rstiebel/Bohlebots_Atlantis/README

This is the Bohlebots Atlantis folder.
It contains all the files that have been used to create the robocup 2vs2 vision soccer bots

Also have a look at the main Bohlebots Github:
https://github.com/bohlebots/soccer
