rstiebel/Bohlebots_Atlantis/Hardware/tasterPlatine2025_01.kicad_pcb

## KiCad design Hardware/tasterPlatine2025_01.kicad_pcb (2026-06-28)

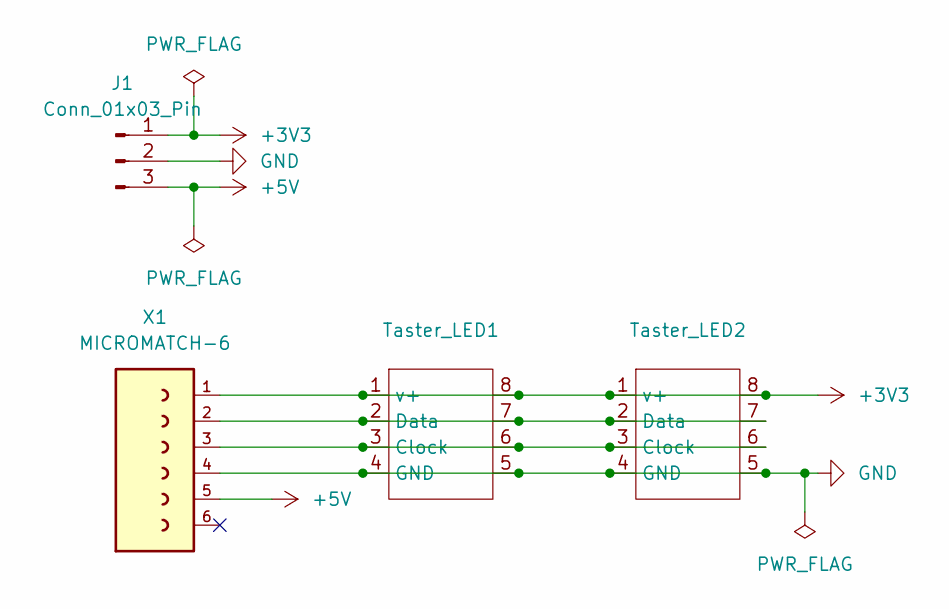
[picture p1: schematic tasterPlatine2025_01.kicad_sch]

Parts:
J1: Conn_01x03_Pin; PinHeader_1x03_P2.54mm_Vertical
Taster_LED1, Taster_LED2: TASTER_LED
X1: MICROMATCH-6

Connections:
+3V3: J1.1, Taster_LED1.1 (v+), Taster_LED1.8, Taster_LED2.1 (v+), Taster_LED2.8, X1.1
+5V: J1.3, X1.5
GND: J1.2, Taster_LED1.4 (GND), Taster_LED1.5, Taster_LED2.4 (GND), Taster_LED2.5, X1.4
unnamed: Taster_LED1.3 (Clock), Taster_LED1.6, Taster_LED2.3 (Clock), Taster_LED2.6, X1.3
unnamed: Taster_LED1.2 (Data), Taster_LED1.7, Taster_LED2.2 (Data), Taster_LED2.7, X1.2

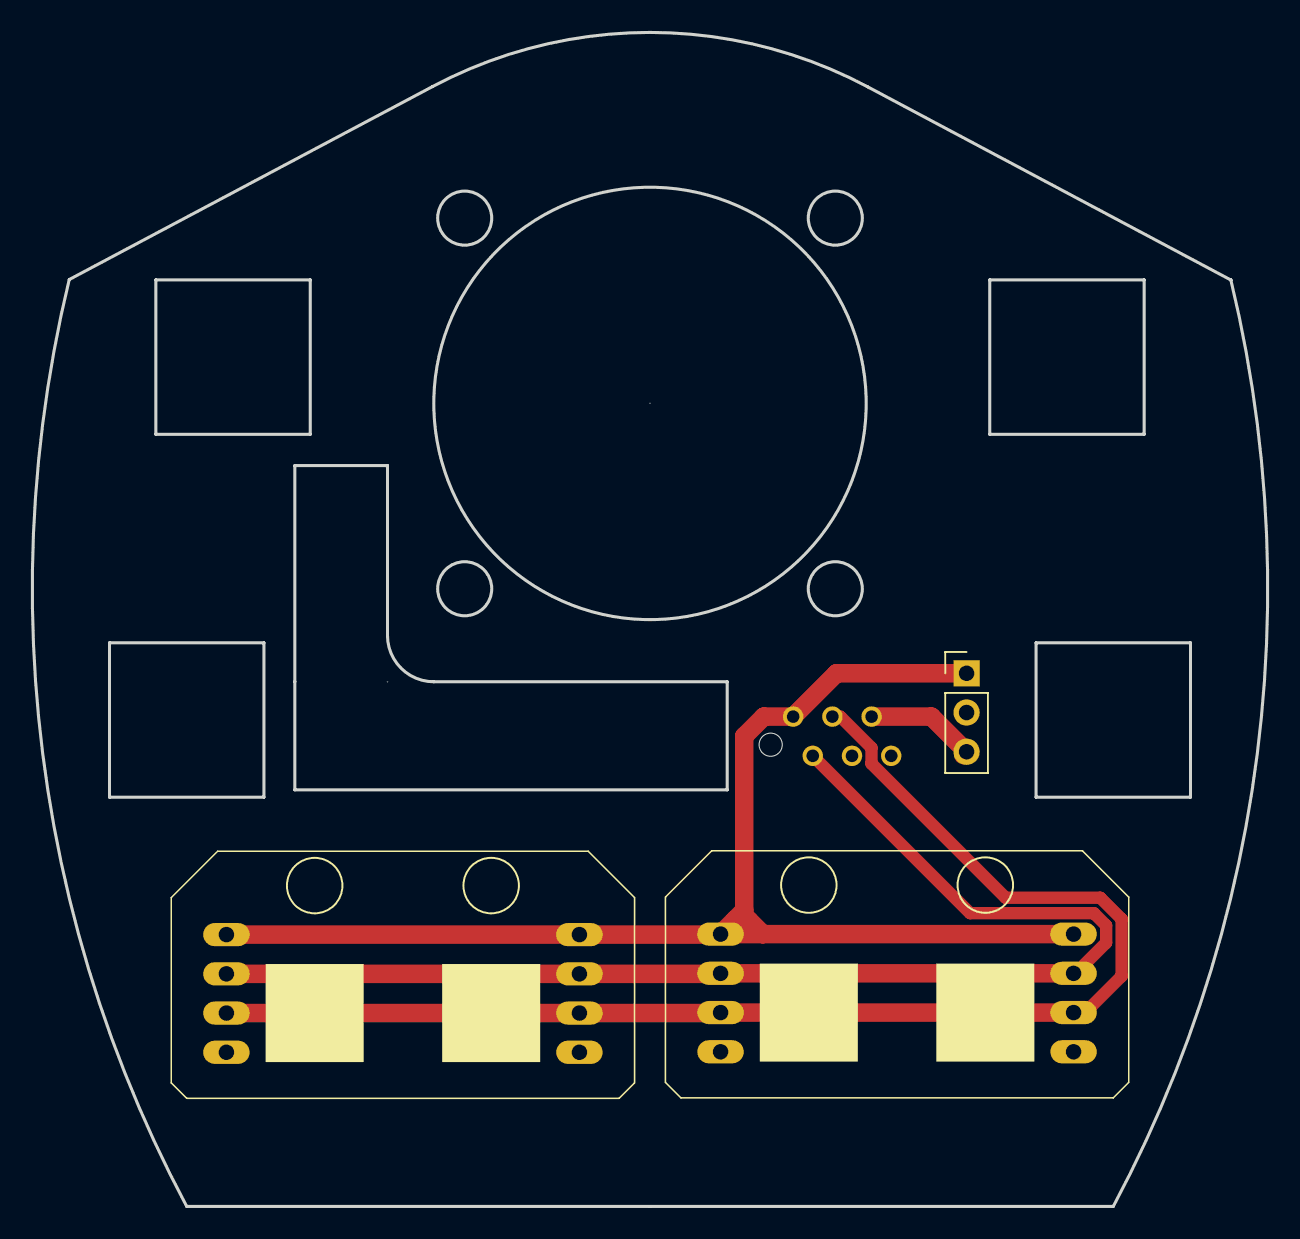
[picture p2: board tasterPlatine2025_01.kicad_pcb from above]

Board: 2 copper layers, 80.0 x 76.0 mm, 4 parts (1 on the bottom side), 5 nets.
