rstiebel/Bohlebots_Atlantis/Hardware/MainPlatine.kicad_pcb

## KiCad design Hardware/MainPlatine.kicad_pcb (2026-06-28)

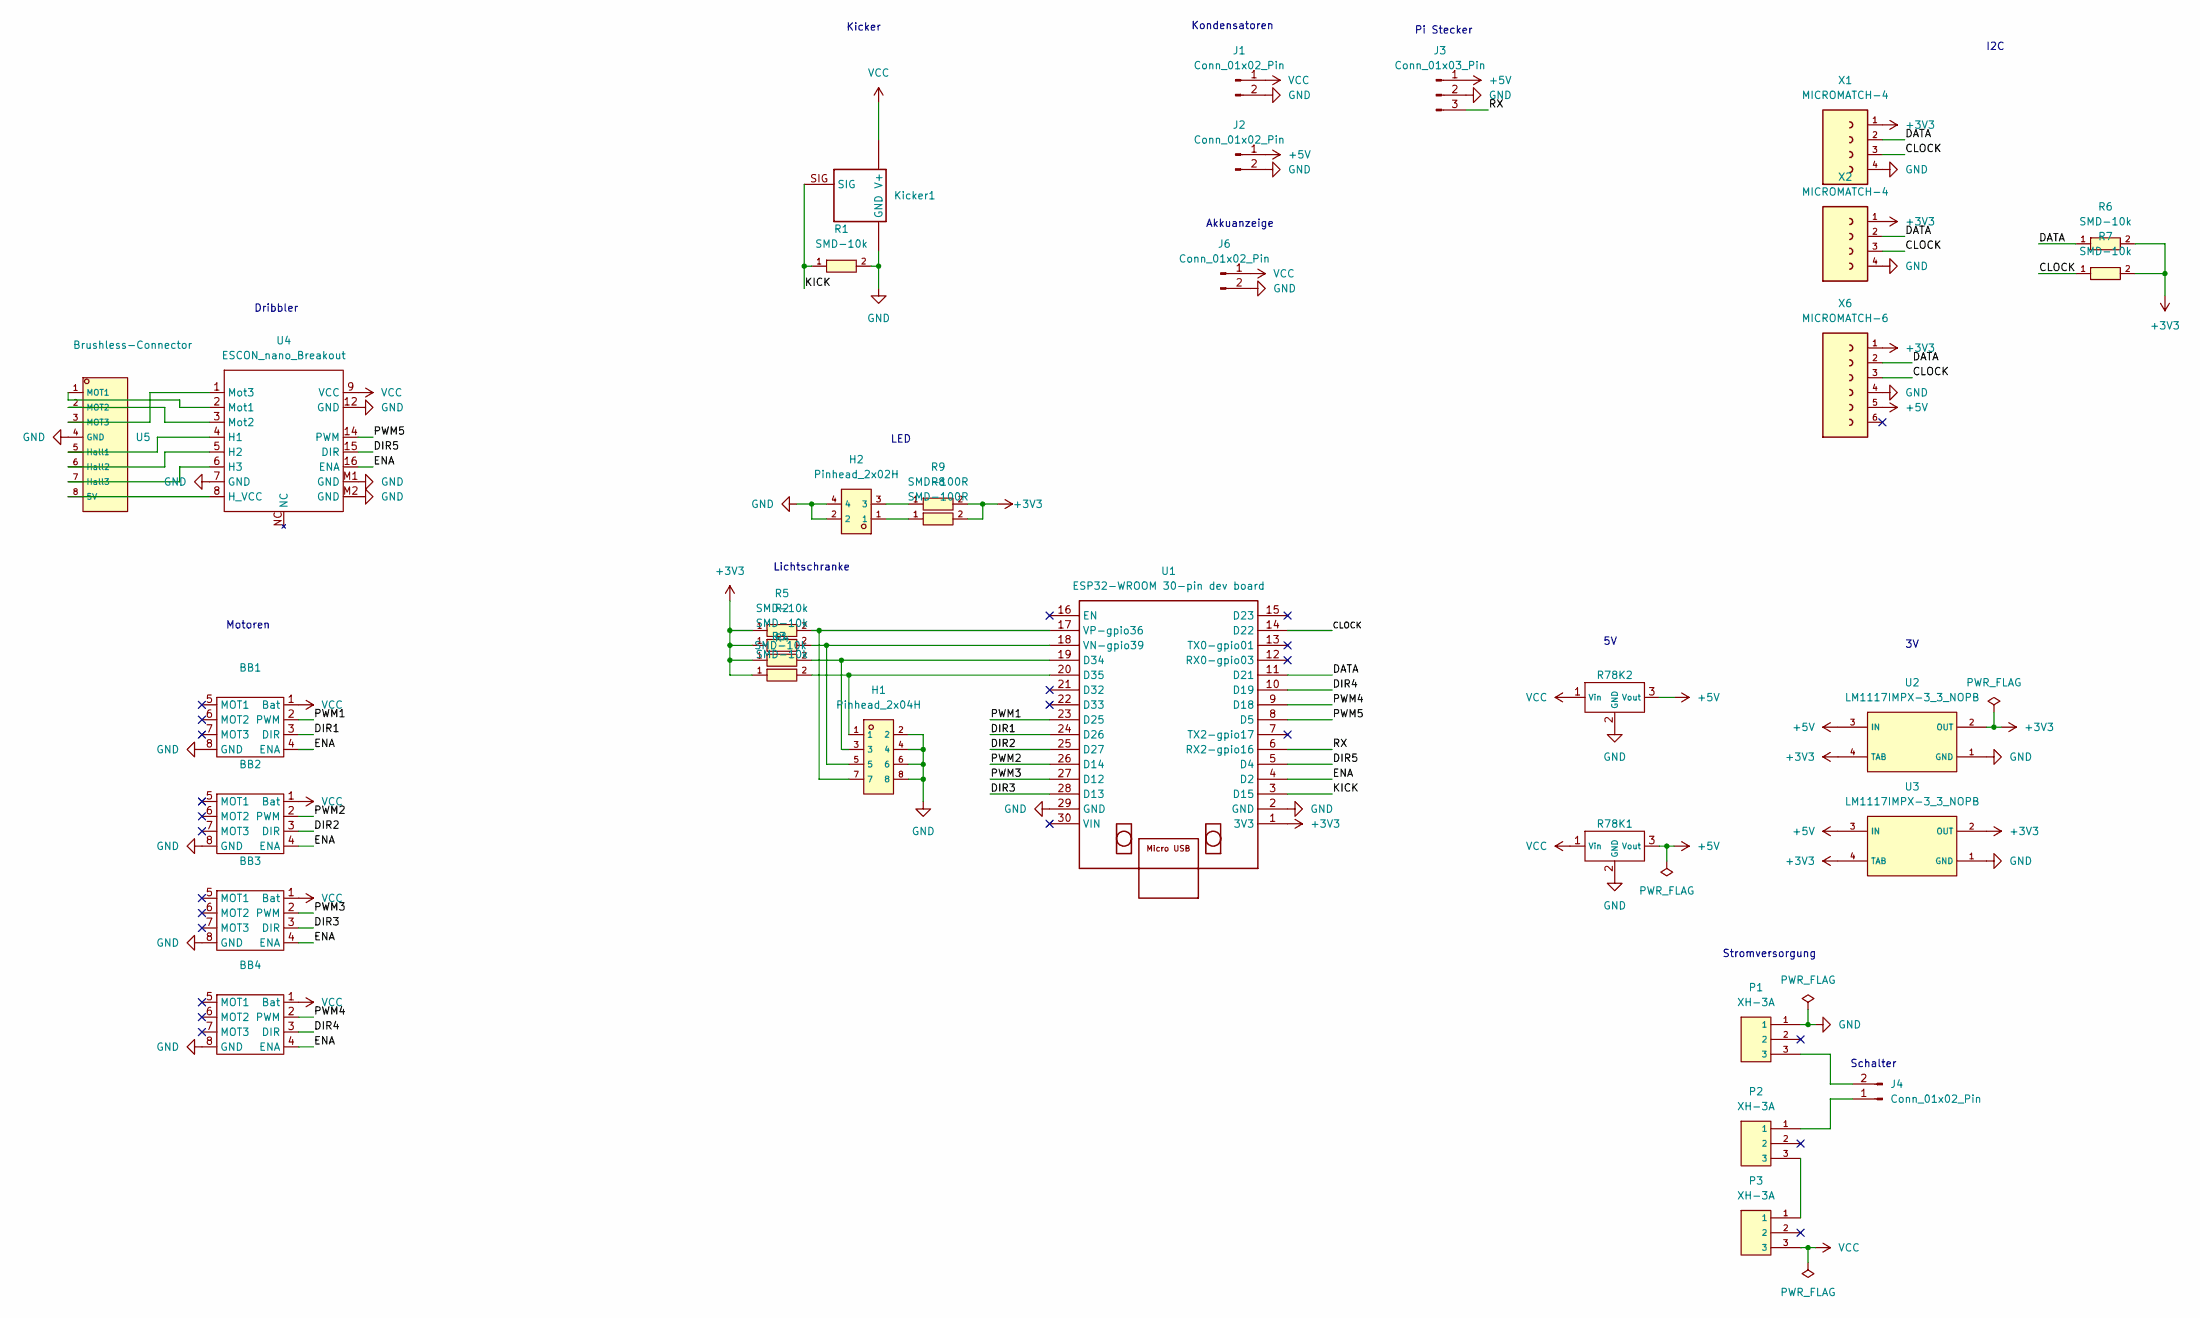
[picture p3: schematic MainPlatine.kicad_sch]

Parts:
BB1, BB2, BB3, BB4: ESCON_nano_breakout_stie
H1: Pinhead_2x04H; PinHeader_2x04_P2.54mm_Vertical; LCSC C706885
H2: Pinhead_2x02H; PinHeader_2x02_P2.54mm_Vertical; LCSC C706883
J1, J2, J4, J6: Conn_01x02_Pin; PinHeader_1x02_P2.54mm_Vertical
J3: Conn_01x03_Pin; PinHeader_1x03_P2.54mm_Vertical
Kicker1: KICKER
P1, P2, P3: XH-3A; CONN-TH_XH-3A; LCSC C2316
R1, R2, R3, R4, R5, R6, R7: SMD-10k; R0603; LCSC C25804
R8, R9: SMD-100R; R0603; LCSC C22775
R78K1, R78K2: R785K
U1: ESP32-WROOM 30-pin dev board; MODULE_ESP32_DEVKIT_V1
U2, U3: LM1117IMPX-3_3_NOPB; SOT-223_L6.5-W3.5-P2.30-LS7.0-BR; LCSC C23984
U4: ESCON_nano_Breakout; ESCON 24-2 Breakout
U5: Brushless-Connector; CONN-TH_B8B-PH-K-S-LF-SN; LCSC C157974
X1, X2: MICROMATCH-4
X6: MICROMATCH-6

Connections:
+3V3: R2.1, R3.1, R4.1, R5.1, R6.2, R7.2, R8.2, R9.2, U1.1 (3V3), U2.2 (OUT), U2.4 (TAB), U3.2 (OUT), U3.4 (TAB), X1.1, X2.1, X6.1
+5V: J2.1, J3.1, R78K1.3 (Vout), R78K2.3 (Vout), U2.3 (IN), U3.3 (IN), X6.5
/CLOCK: R7.1, U1.14 (D22), X1.3, X2.3, X6.3
/DATA: R6.1, U1.11 (D21), X1.2, X2.2, X6.2
/DIR1: BB1.3 (DIR), U1.24 (D26)
/DIR2: BB2.3 (DIR), U1.25 (D27)
/DIR3: BB3.3 (DIR), U1.28 (D13)
/DIR4: BB4.3 (DIR), U1.10 (D19)
/DIR5: U1.5 (D4), U4.15 (DIR)
/ENA: BB1.4 (ENA), BB2.4 (ENA), BB3.4 (ENA), BB4.4 (ENA), U1.4 (D2), U4.16 (ENA)
/KICK: Kicker1.SIG, R1.1, U1.3 (D15)
/PWM1: BB1.2 (PWM), U1.23 (D25)
/PWM2: BB2.2 (PWM), U1.26 (D14)
/PWM3: BB3.2 (PWM), U1.27 (D12)
/PWM4: BB4.2 (PWM), U1.9 (D18)
/PWM5: U1.8 (D5), U4.14 (PWM)
/RX: J3.3, U1.6 (RX2-gpio16)
GND: BB1.8 (GND), BB2.8 (GND), BB3.8 (GND), BB4.8 (GND), H1.2, H1.4, H1.6, H1.8, H2.2, H2.4, J1.2, J2.2, J3.2, J6.2, Kicker1.GND1 (GND), Kicker1.GND2 (GND), Kicker1.GND3 (GND), Kicker1.GND4 (GND), Kicker1.GND5 (GND), Kicker1.GND6 (GND), Kicker1.GND7 (GND), Kicker1.GND8 (GND), P1.1, R1.2, R78K1.2 (GND), R78K2.2 (GND), U1.2 (GND), U1.29 (GND), U2.1 (GND), U3.1 (GND), U4.7 (GND), U4.12 (GND), U4.13 (GND), U4.M1 (GND), U4.M2 (GND), U5.4 (GND), X1.4, X2.4, X6.4
unnamed: H2.1, R8.1
unnamed: H2.3, R9.1
unnamed: J4.1, P2.1
unnamed: J4.2, P1.3
unnamed: P2.3, P3.1
unnamed: H1.3, R3.2, U1.19 (D34)
unnamed: H1.1, R4.2, U1.20 (D35)
unnamed: H1.5, R2.2, U1.18 (VN-gpio39)
unnamed: H1.7, R5.2, U1.17 (VP-gpio36)
unnamed: U4.4 (H1), U5.5 (Hall1)
unnamed: U4.5 (H2), U5.6 (Hall2)
unnamed: U4.6 (H3), U5.7 (Hall3)
unnamed: U4.8 (H_VCC), U5.8 (5V)
unnamed: U4.2 (Mot1), U5.1 (MOT1)
unnamed: U4.3 (Mot2), U5.2 (MOT2)
unnamed: U4.1 (Mot3), U5.3 (MOT3)
VCC: BB1.1 (Bat), BB2.1 (Bat), BB3.1 (Bat), BB4.1 (Bat), J1.1, J6.1, Kicker1.V+1 (V+), Kicker1.V+2 (V+), Kicker1.V+3 (V+), P3.3, R78K1.1 (Vin), R78K2.1 (Vin), U4.9 (VCC), U4.10 (VCC), U4.11 (VCC)

Notes on the sheet:
I2C
Kondensatoren
Stromversorgung
Pi Stecker
Schalter
Dribbler
Kicker
LED
Akkuanzeige
Motoren
Lichtschranke

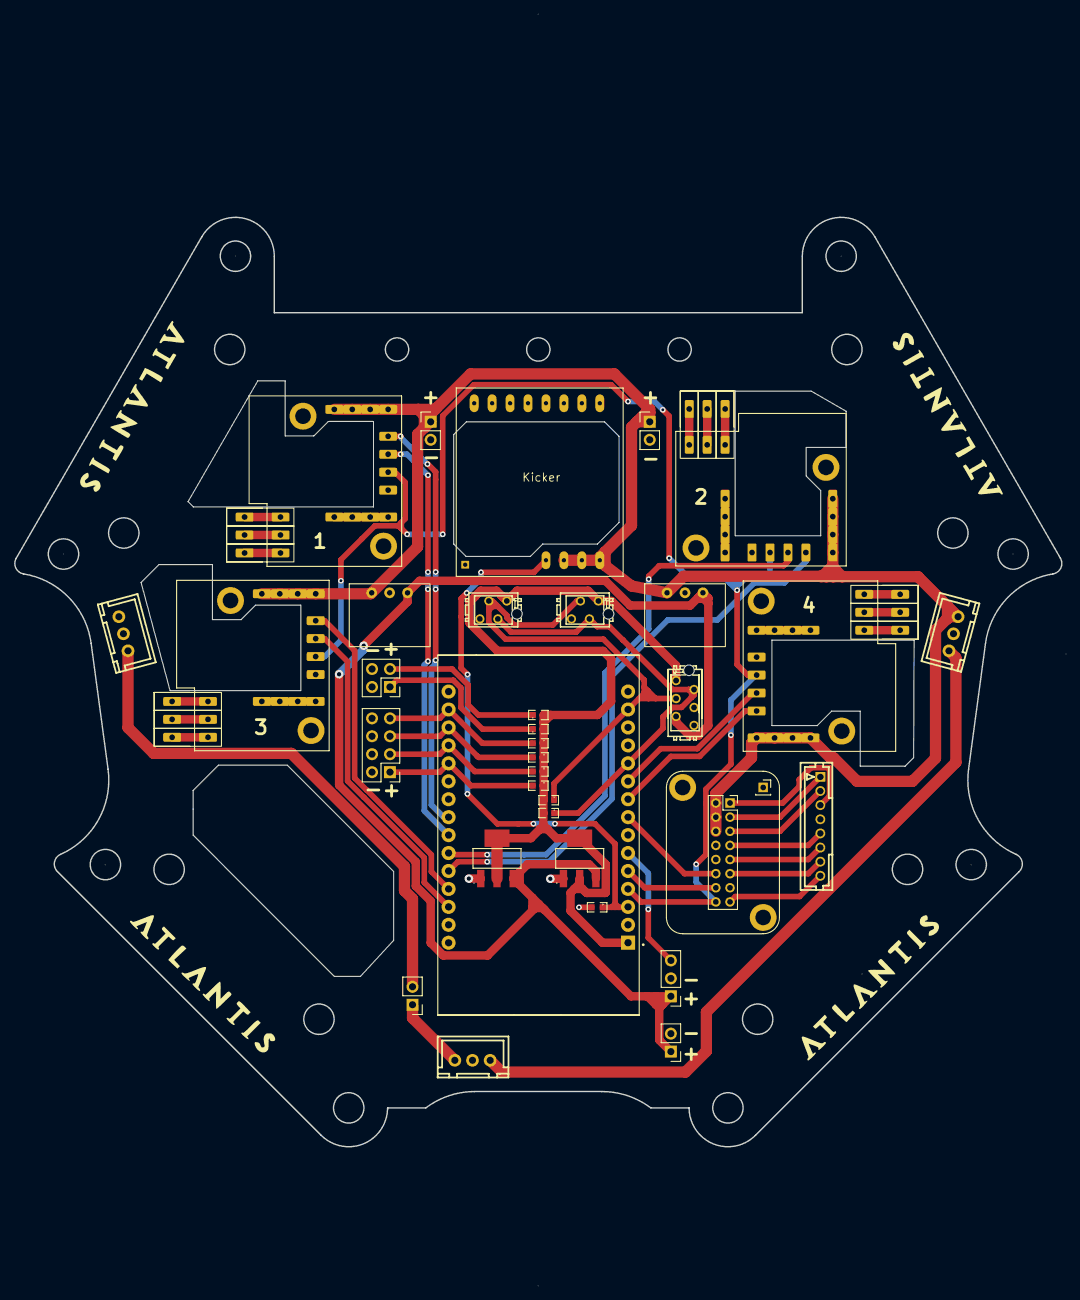
[picture p4: board MainPlatine.kicad_pcb from above]

Board: 2 copper layers, 148.2 x 131.6 mm, 34 parts (0 on the bottom side), 35 nets.
