rstiebel/Bohlebots_Atlantis/Hardware/Bodensensor_2025_final.kicad_pcb

## KiCad design Hardware/Bodensensor_2025_final.kicad_pcb (2026-06-28)

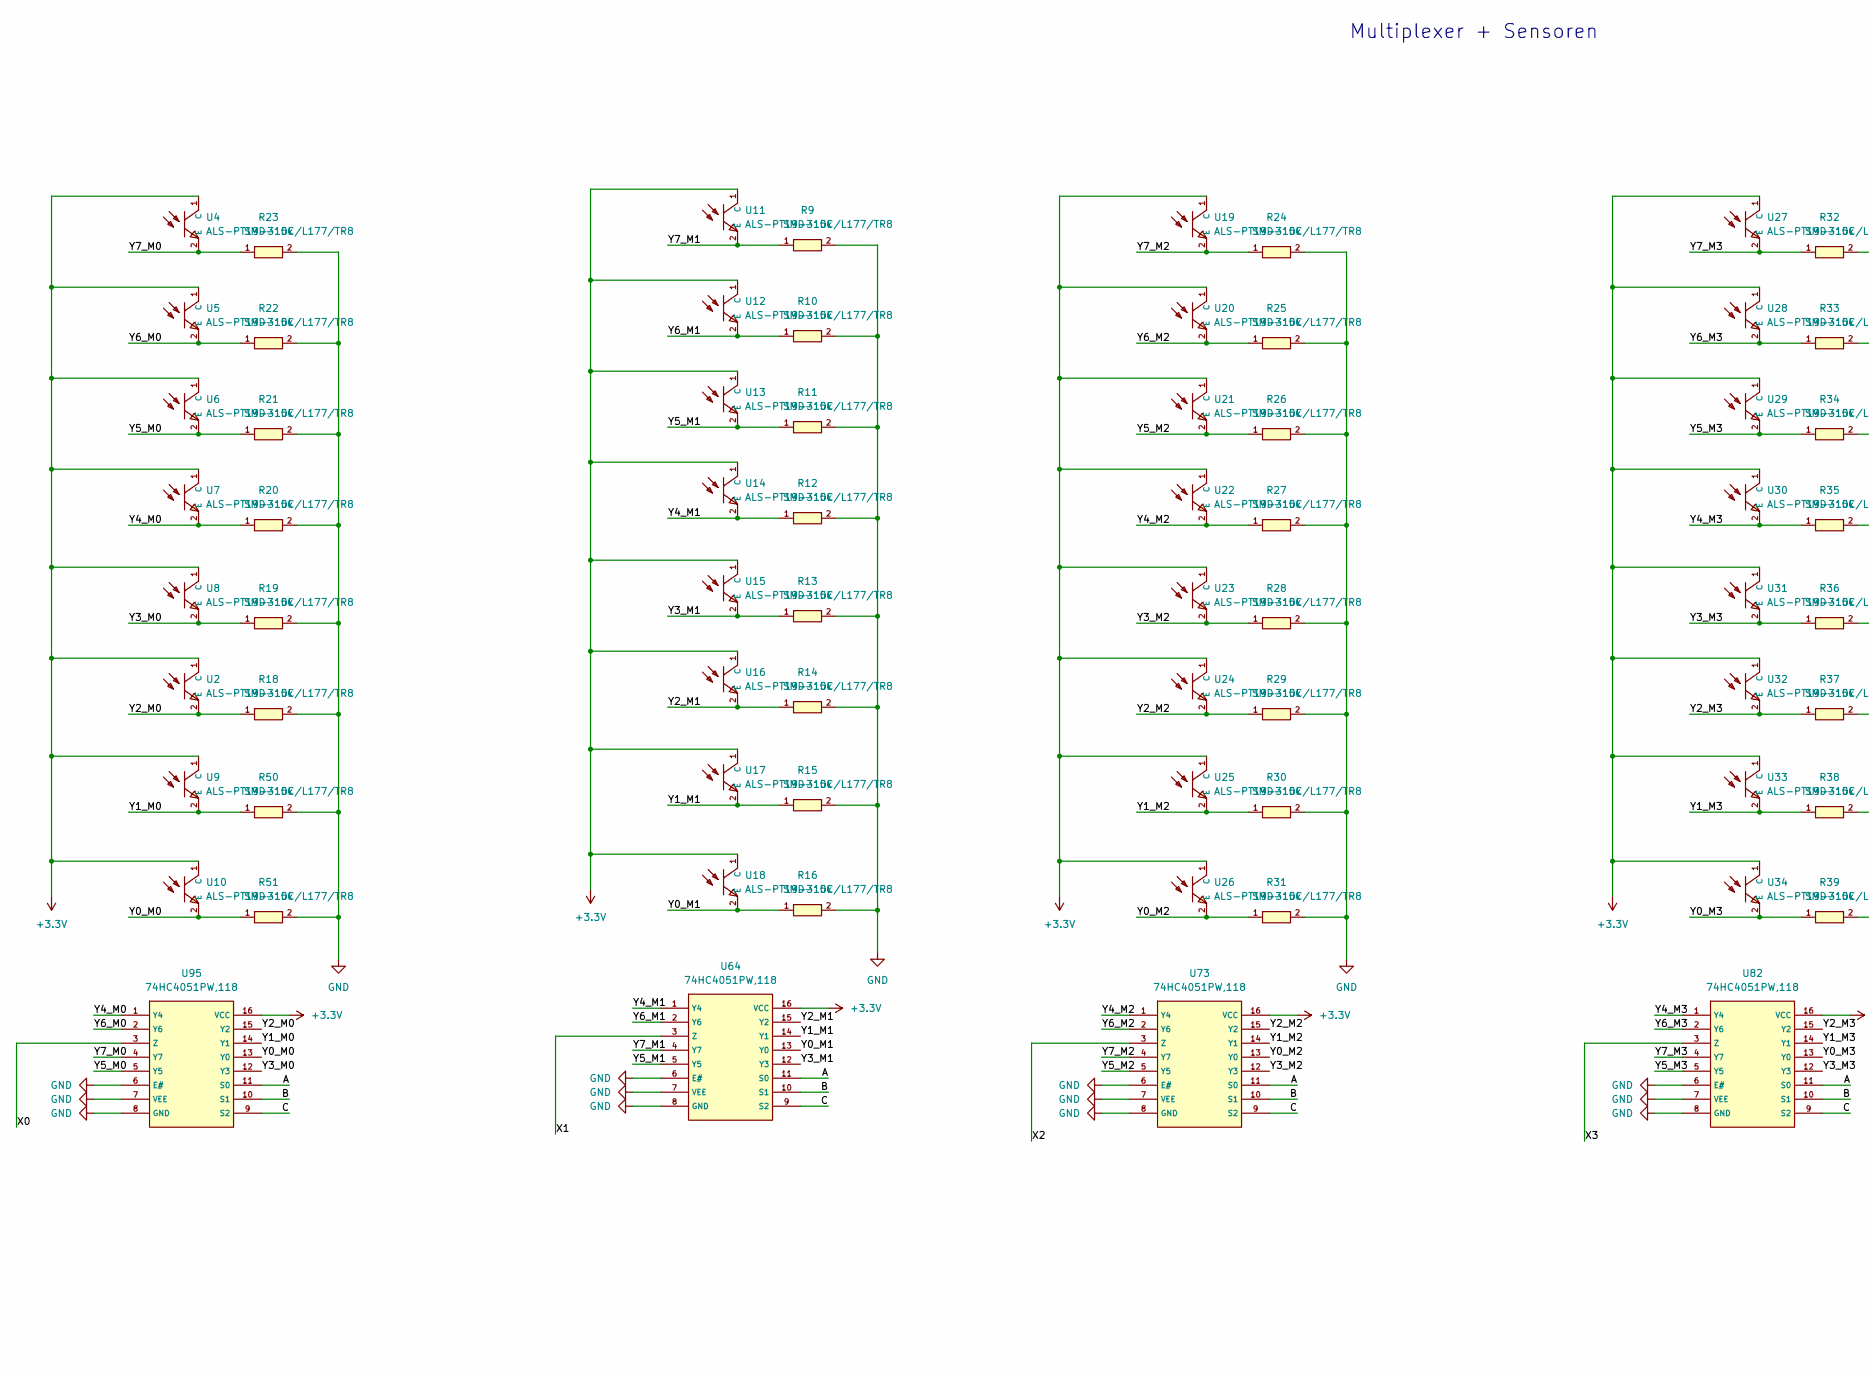
[picture p5: schematic Bodensensor_2025_final.kicad_sch, part in row 1, column 1]

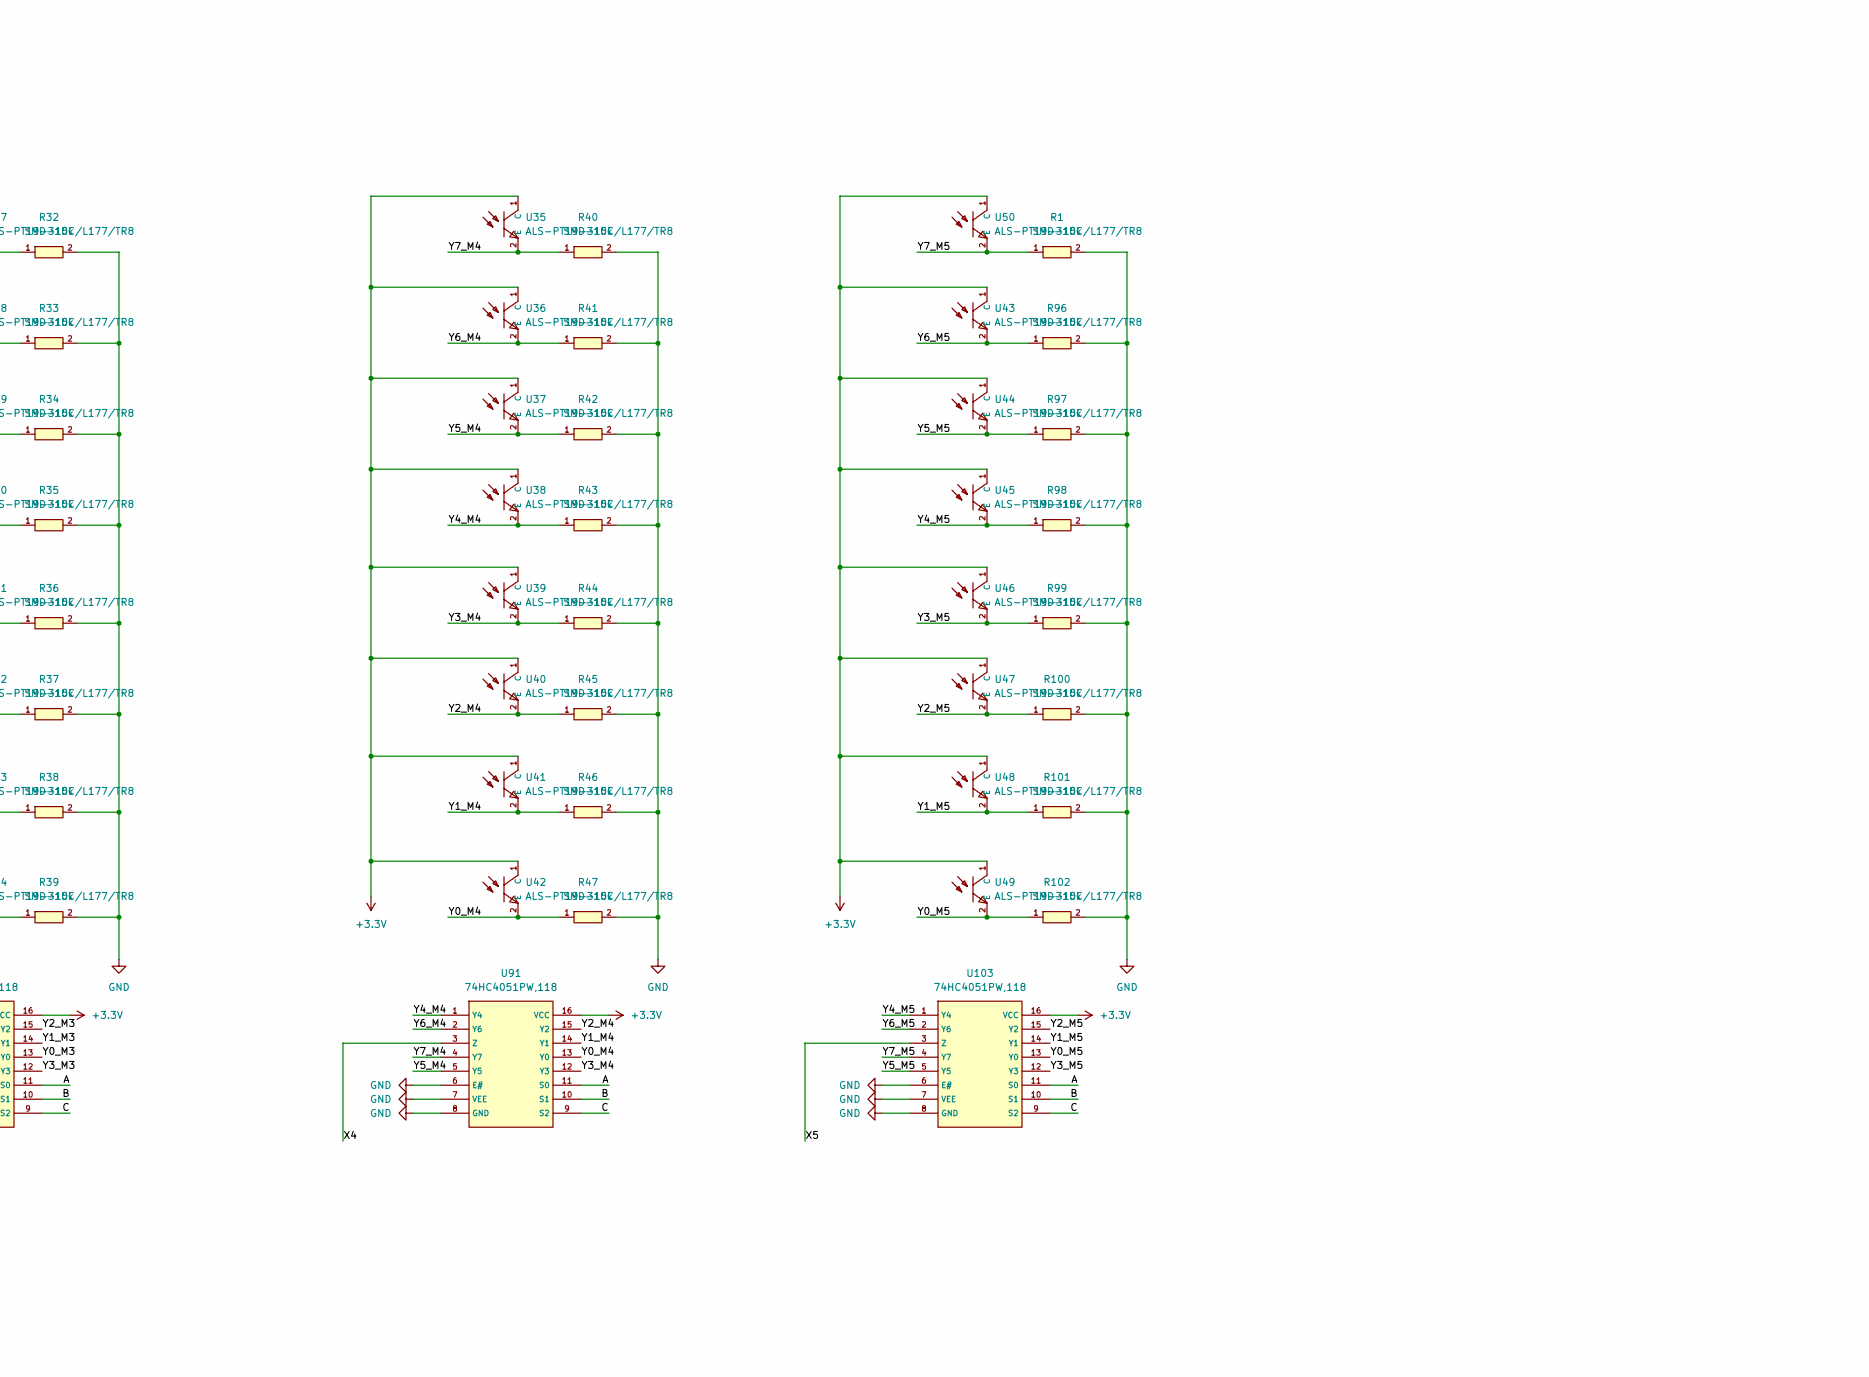
[picture p6: schematic Bodensensor_2025_final.kicad_sch, part in row 1, column 2]

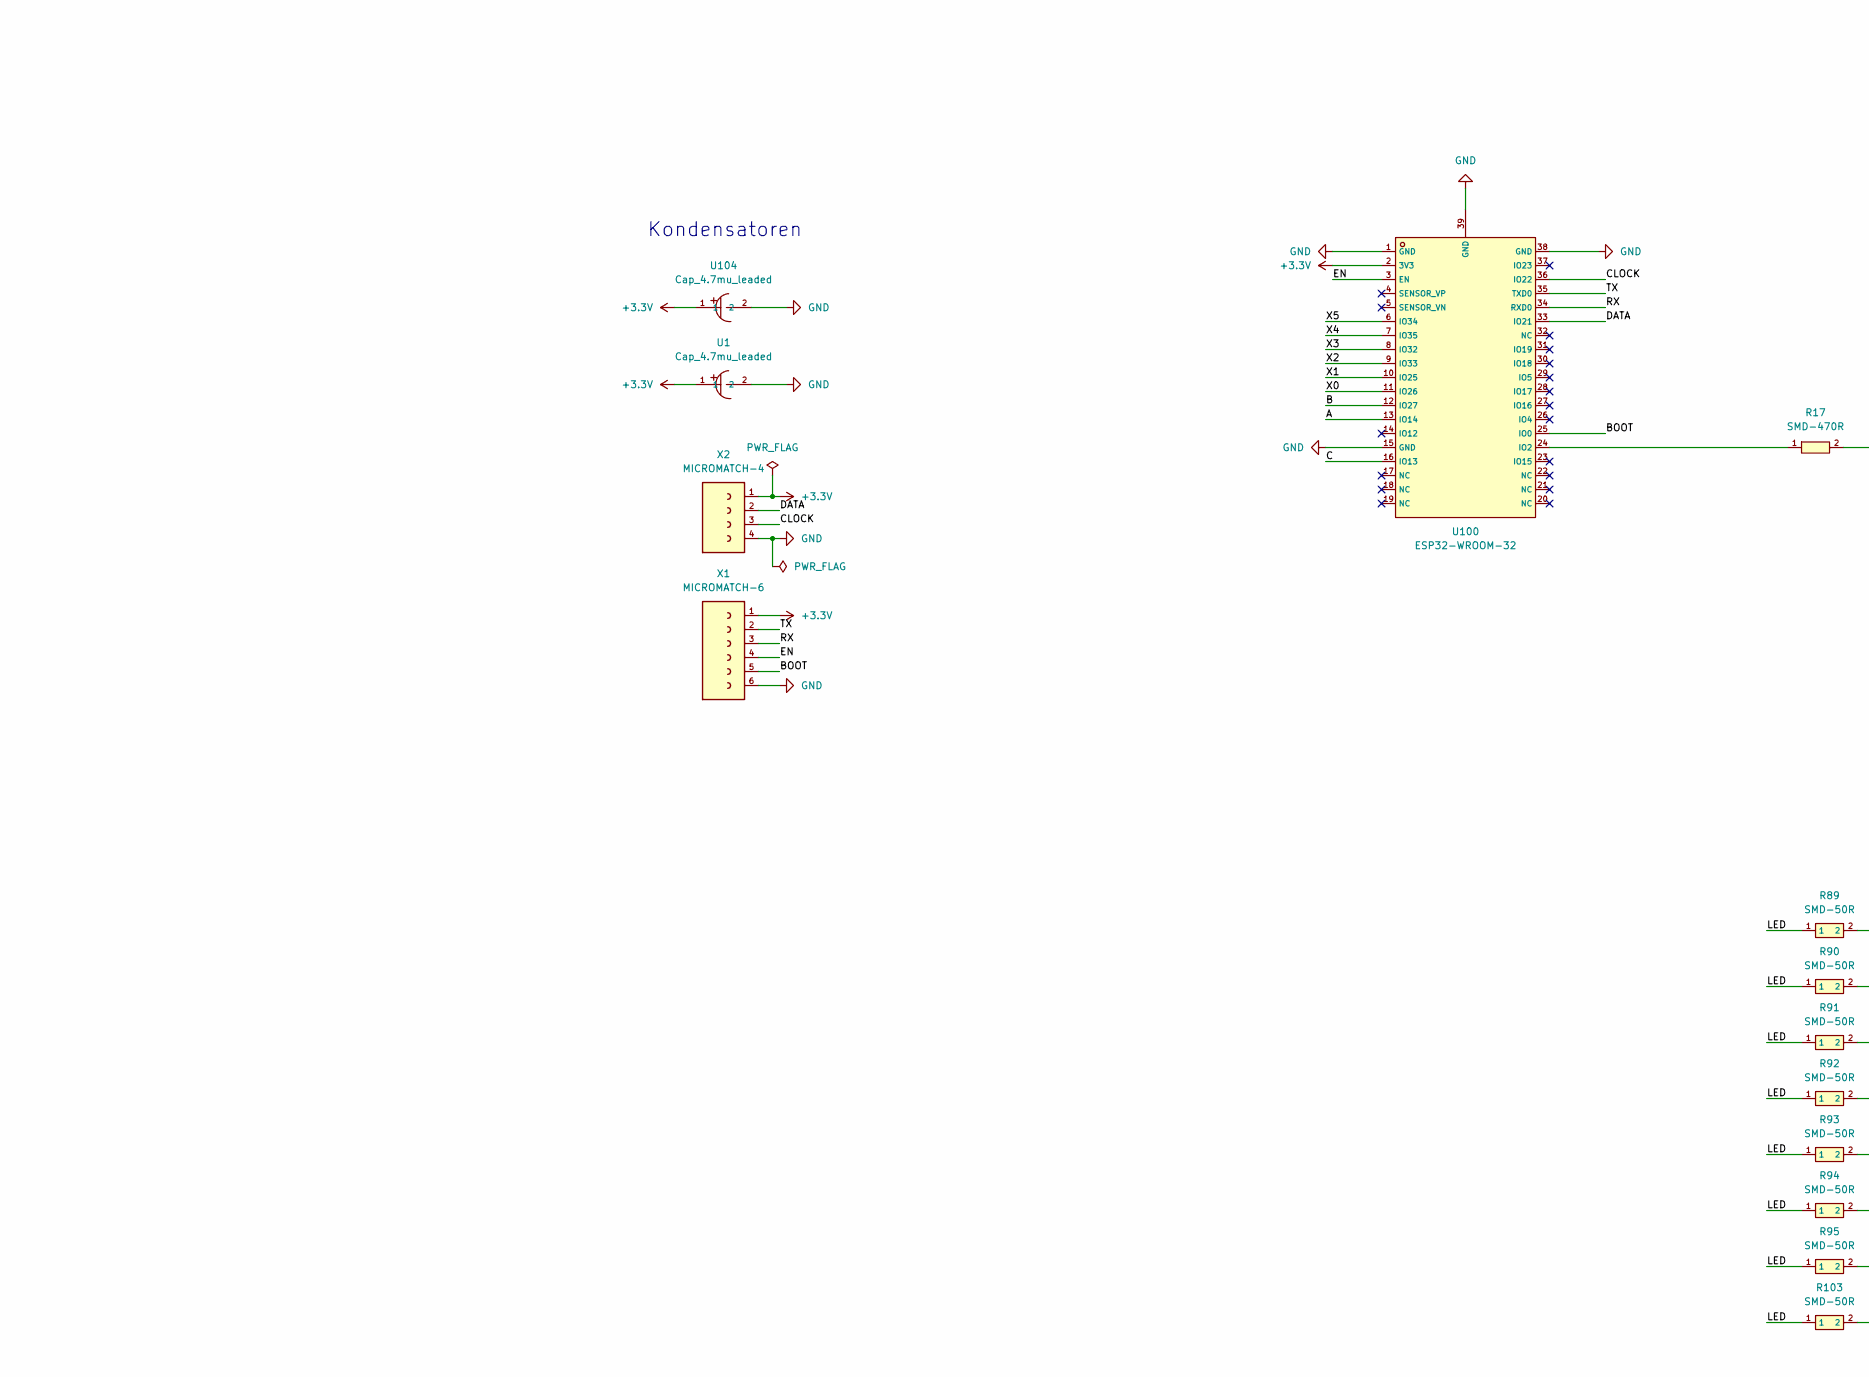
[picture p7: schematic Bodensensor_2025_final.kicad_sch, part in row 2, column 1]

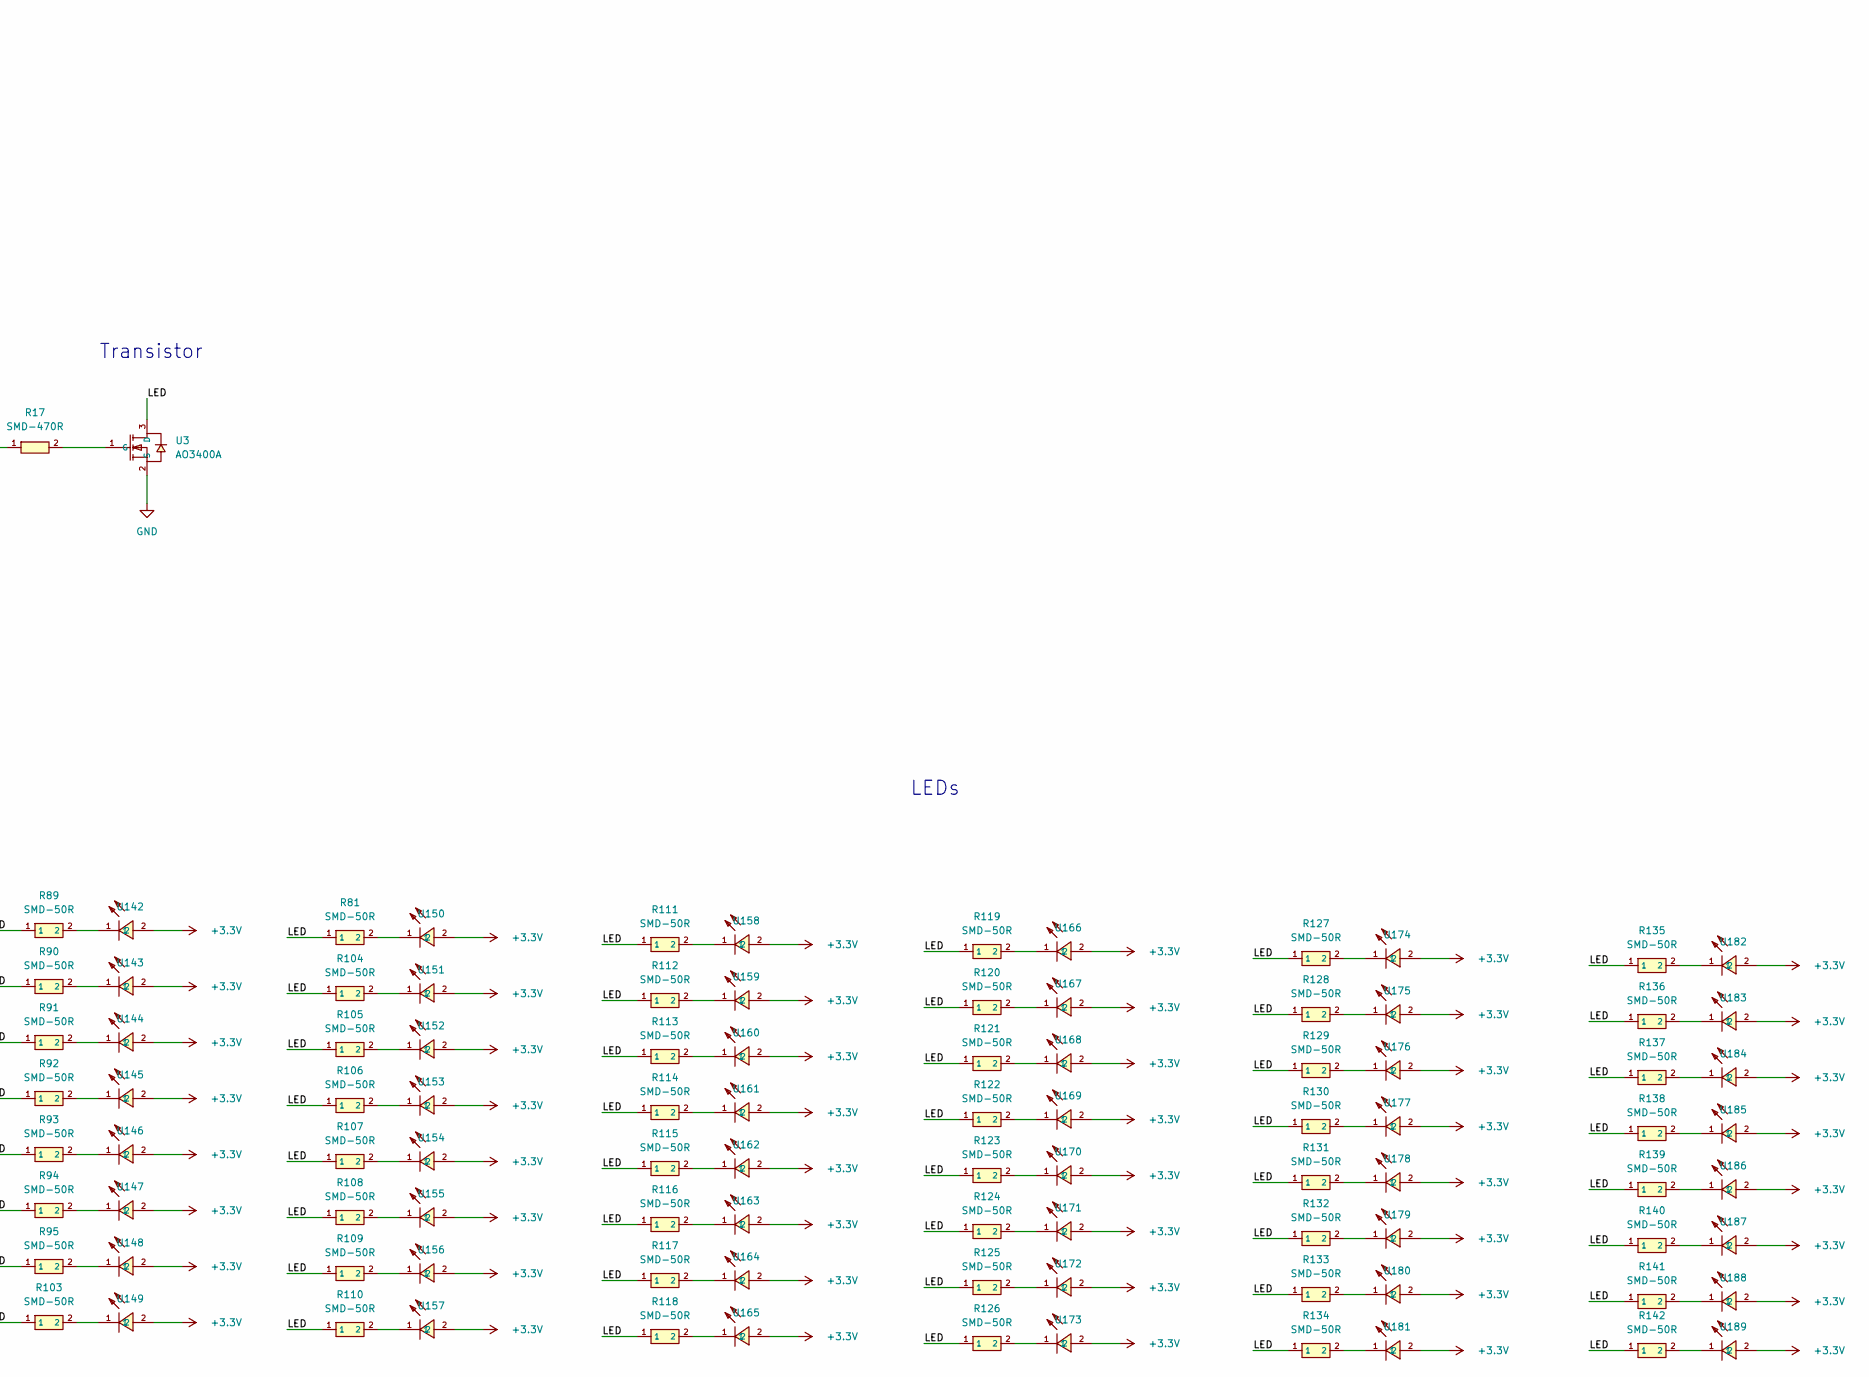
[picture p8: schematic Bodensensor_2025_final.kicad_sch, part in row 2, column 2]

Parts:
R1, R9, R10, R11, R12, R13, R14, R15, R16, R18, R19, R20, R21, R22, R23, R24, R25, R26, R27, R28, R29, R30, R31, R32, R33, R34, R35, R36, R37, R38, R39, R40, R41, R42, R43, R44, R45, R46, R47, R50, R51, R96, R97, R98, R99, R100, R101, R102: SMD-10k; R0603; LCSC C25804
R17: SMD-470R; R0603; LCSC C23162
R81, R89, R90, R91, R92, R93, R94, R95, R103, R104, R105, R106, R107, R108, R109, R110, R111, R112, R113, R114, R115, R116, R117, R118, R119, R120, R121, R122, R123, R124, R125, R126, R127, R128, R129, R130, R131, R132, R133, R134, R135, R136, R137, R138, R139, R140, R141, R142: SMD-50R; R0603; LCSC C849792
U1, U104: Cap_4.7mu_leaded; CAP-TH_BD4.0-P1.50-D0.5-FD; LCSC C2873979
U2, U4, U5, U6, U7, U8, U9, U10, U11, U12, U13, U14, U15, U16, U17, U18, U19, U20, U21, U22, U23, U24, U25, U26, U27, U28, U29, U30, U31, U32, U33, U34, U35, U36, U37, U38, U39, U40, U41, U42, U43, U44, U45, U46, U47, U48, U49, U50: ALS-PT19-315C/L177/TR8; SENSORS-SMD_ALS-PT19; LCSC C146233
U3: AO3400A; SOT-23-3_L2.9-W1.3-P1.90-LS2.4-BR; LCSC C20917
U64, U73, U82, U91, U95, U103: 74HC4051PW,118; TSSOP-16_L5.0-W4.4-P0.65-LS6.4-BL; LCSC C5645
U100: ESP32-WROOM-32; WIFI-SMD_ESP32-WROOM-32UE; LCSC C701344
U142, U143, U144, U145, U146, U147, U148, U149, U150, U151, U152, U153, U154, U155, U156, U157, U158, U159, U160, U161, U162, U163, U164, U165, U166, U167, U168, U169, U170, U171, U172, U173, U174, U175, U176, U177, U178, U179, U180, U181, U182, U183, U184, U185, U186, U187, U188, U189: LED weiß 4000k Bodensensor HL-AM-2835H489W-S1-08H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; LED-SMD_L3.3-W2.8-RD; LCSC C210311
X1: MICROMATCH-6
X2: MICROMATCH-4

Connections:
+3.3V: U1.1, U2.1 (C), U4.1 (C), U5.1 (C), U6.1 (C), U7.1 (C), U8.1 (C), U9.1 (C), U10.1 (C), U11.1 (C), U12.1 (C), U13.1 (C), U14.1 (C), U15.1 (C), U16.1 (C), U17.1 (C), U18.1 (C), U19.1 (C), U20.1 (C), U21.1 (C), U22.1 (C), U23.1 (C), U24.1 (C), U25.1 (C), U26.1 (C), U27.1 (C), U28.1 (C), U29.1 (C), U30.1 (C), U31.1 (C), U32.1 (C), U33.1 (C), U34.1 (C), U35.1 (C), U36.1 (C), U37.1 (C), U38.1 (C), U39.1 (C), U40.1 (C), U41.1 (C), U42.1 (C), U43.1 (C), U44.1 (C), U45.1 (C), U46.1 (C), U47.1 (C), U48.1 (C), U49.1 (C), U50.1 (C), U64.16 (VCC), U73.16 (VCC), U82.16 (VCC), U91.16 (VCC), U95.16 (VCC), U100.2 (3V3), U103.16 (VCC), U104.1, U142.2, U143.2, U144.2, U145.2, U146.2, U147.2, U148.2, U149.2, U150.2, U151.2, U152.2, U153.2, U154.2, U155.2, U156.2, U157.2, U158.2, U159.2, U160.2, U161.2, U162.2, U163.2, U164.2, U165.2, U166.2, U167.2, U168.2, U169.2, U170.2, U171.2, U172.2, U173.2, U174.2, U175.2, U176.2, U177.2, U178.2, U179.2, U180.2, U181.2, U182.2, U183.2, U184.2, U185.2, U186.2, U187.2, U188.2, U189.2, X1.1, X2.1
/A: U64.11 (S0), U73.11 (S0), U82.11 (S0), U91.11 (S0), U95.11 (S0), U100.13 (IO14), U103.11 (S0)
/B: U64.10 (S1), U73.10 (S1), U82.10 (S1), U91.10 (S1), U95.10 (S1), U100.12 (IO27), U103.10 (S1)
/BOOT: U100.25 (IO0), X1.5
/C: U64.9 (S2), U73.9 (S2), U82.9 (S2), U91.9 (S2), U95.9 (S2), U100.16 (IO13), U103.9 (S2)
/CLOCK: U100.36 (IO22), X2.3
/DATA: U100.33 (IO21), X2.2
/EN: U100.3 (EN), X1.4
/LED: R81.1, R89.1, R90.1, R91.1, R92.1, R93.1, R94.1, R95.1, R103.1, R104.1, R105.1, R106.1, R107.1, R108.1, R109.1, R110.1, R111.1, R112.1, R113.1, R114.1, R115.1, R116.1, R117.1, R118.1, R119.1, R120.1, R121.1, R122.1, R123.1, R124.1, R125.1, R126.1, R127.1, R128.1, R129.1, R130.1, R131.1, R132.1, R133.1, R134.1, R135.1, R136.1, R137.1, R138.1, R139.1, R140.1, R141.1, R142.1, U3.3 (D)
/RX: U100.34 (RXD0), X1.3
/TX: U100.35 (TXD0), X1.2
/X0: U95.3 (Z), U100.11 (IO26)
/X1: U64.3 (Z), U100.10 (IO25)
/X2: U73.3 (Z), U100.9 (IO33)
/X3: U82.3 (Z), U100.8 (IO32)
/X4: U91.3 (Z), U100.7 (IO35)
/X5: U100.6 (IO34), U103.3 (Z)
/Y0_M0: R51.1, U10.2 (E), U95.13 (Y0)
/Y0_M1: R16.1, U18.2 (E), U64.13 (Y0)
/Y0_M2: R31.1, U26.2 (E), U73.13 (Y0)
/Y0_M3: R39.1, U34.2 (E), U82.13 (Y0)
/Y0_M4: R47.1, U42.2 (E), U91.13 (Y0)
/Y0_M5: R102.1, U49.2 (E), U103.13 (Y0)
/Y1_M0: R50.1, U9.2 (E), U95.14 (Y1)
/Y1_M1: R15.1, U17.2 (E), U64.14 (Y1)
/Y1_M2: R30.1, U25.2 (E), U73.14 (Y1)
/Y1_M3: R38.1, U33.2 (E), U82.14 (Y1)
/Y1_M4: R46.1, U41.2 (E), U91.14 (Y1)
/Y1_M5: R101.1, U48.2 (E), U103.14 (Y1)
/Y2_M0: R18.1, U2.2 (E), U95.15 (Y2)
/Y2_M1: R14.1, U16.2 (E), U64.15 (Y2)
/Y2_M2: R29.1, U24.2 (E), U73.15 (Y2)
/Y2_M3: R37.1, U32.2 (E), U82.15 (Y2)
/Y2_M4: R45.1, U40.2 (E), U91.15 (Y2)
/Y2_M5: R100.1, U47.2 (E), U103.15 (Y2)
/Y3_M0: R19.1, U8.2 (E), U95.12 (Y3)
/Y3_M1: R13.1, U15.2 (E), U64.12 (Y3)
/Y3_M2: R28.1, U23.2 (E), U73.12 (Y3)
/Y3_M3: R36.1, U31.2 (E), U82.12 (Y3)
/Y3_M4: R44.1, U39.2 (E), U91.12 (Y3)
/Y3_M5: R99.1, U46.2 (E), U103.12 (Y3)
/Y4_M0: R20.1, U7.2 (E), U95.1 (Y4)
/Y4_M1: R12.1, U14.2 (E), U64.1 (Y4)
/Y4_M2: R27.1, U22.2 (E), U73.1 (Y4)
/Y4_M3: R35.1, U30.2 (E), U82.1 (Y4)
/Y4_M4: R43.1, U38.2 (E), U91.1 (Y4)
/Y4_M5: R98.1, U45.2 (E), U103.1 (Y4)
/Y5_M0: R21.1, U6.2 (E), U95.5 (Y5)
/Y5_M1: R11.1, U13.2 (E), U64.5 (Y5)
/Y5_M2: R26.1, U21.2 (E), U73.5 (Y5)
/Y5_M3: R34.1, U29.2 (E), U82.5 (Y5)
/Y5_M4: R42.1, U37.2 (E), U91.5 (Y5)
/Y5_M5: R97.1, U44.2 (E), U103.5 (Y5)
/Y6_M0: R22.1, U5.2 (E), U95.2 (Y6)
/Y6_M1: R10.1, U12.2 (E), U64.2 (Y6)
/Y6_M2: R25.1, U20.2 (E), U73.2 (Y6)
/Y6_M3: R33.1, U28.2 (E), U82.2 (Y6)
/Y6_M4: R41.1, U36.2 (E), U91.2 (Y6)
/Y6_M5: R96.1, U43.2 (E), U103.2 (Y6)
/Y7_M0: R23.1, U4.2 (E), U95.4 (Y7)
/Y7_M1: R9.1, U11.2 (E), U64.4 (Y7)
/Y7_M2: R24.1, U19.2 (E), U73.4 (Y7)
/Y7_M3: R32.1, U27.2 (E), U82.4 (Y7)
/Y7_M4: R40.1, U35.2 (E), U91.4 (Y7)
/Y7_M5: R1.1, U50.2 (E), U103.4 (Y7)
GND: R1.2, R9.2, R10.2, R11.2, R12.2, R13.2, R14.2, R15.2, R16.2, R18.2, R19.2, R20.2, R21.2, R22.2, R23.2, R24.2, R25.2, R26.2, R27.2, R28.2, R29.2, R30.2, R31.2, R32.2, R33.2, R34.2, R35.2, R36.2, R37.2, R38.2, R39.2, R40.2, R41.2, R42.2, R43.2, R44.2, R45.2, R46.2, R47.2, R50.2, R51.2, R96.2, R97.2, R98.2, R99.2, R100.2, R101.2, R102.2, U1.2, U3.2 (S), U64.6 (E#), U64.7 (VEE), U64.8 (GND), U73.6 (E#), U73.7 (VEE), U73.8 (GND), U82.6 (E#), U82.7 (VEE), U82.8 (GND), U91.6 (E#), U91.7 (VEE), U91.8 (GND), U95.6 (E#), U95.7 (VEE), U95.8 (GND), U100.1 (GND), U100.15 (GND), U100.38 (GND), U100.39 (GND), U103.6 (E#), U103.7 (VEE), U103.8 (GND), U104.2, X1.6, X2.4
unnamed: R81.2, U150.1
unnamed: R89.2, U142.1
unnamed: R90.2, U143.1
unnamed: R91.2, U144.1
unnamed: R92.2, U145.1
unnamed: R93.2, U146.1
unnamed: R94.2, U147.1
unnamed: R95.2, U148.1
unnamed: R103.2, U149.1
unnamed: R104.2, U151.1
unnamed: R105.2, U152.1
unnamed: R106.2, U153.1
unnamed: R107.2, U154.1
unnamed: R108.2, U155.1
unnamed: R109.2, U156.1
unnamed: R110.2, U157.1
unnamed: R111.2, U158.1
unnamed: R112.2, U159.1
unnamed: R113.2, U160.1
unnamed: R114.2, U161.1
unnamed: R115.2, U162.1
unnamed: R116.2, U163.1
unnamed: R117.2, U164.1
unnamed: R118.2, U165.1
unnamed: R119.2, U166.1
unnamed: R120.2, U167.1
unnamed: R121.2, U168.1
unnamed: R122.2, U169.1
unnamed: R123.2, U170.1
unnamed: R124.2, U171.1
unnamed: R125.2, U172.1
unnamed: R126.2, U173.1
unnamed: R127.2, U174.1
unnamed: R128.2, U175.1
unnamed: R129.2, U176.1
unnamed: R130.2, U177.1
unnamed: R131.2, U178.1
unnamed: R132.2, U179.1
unnamed: R133.2, U180.1
unnamed: R134.2, U181.1
unnamed: R135.2, U182.1
unnamed: R136.2, U183.1
unnamed: R137.2, U184.1
unnamed: R138.2, U185.1
unnamed: R139.2, U186.1
unnamed: R140.2, U187.1
unnamed: R141.2, U188.1
unnamed: R142.2, U189.1
unnamed: R17.2, U3.1 (G)
unnamed: R17.1, U100.24 (IO2)

Notes on the sheet:
Kondensatoren
Transistor
Multiplexer + Sensoren
LEDs

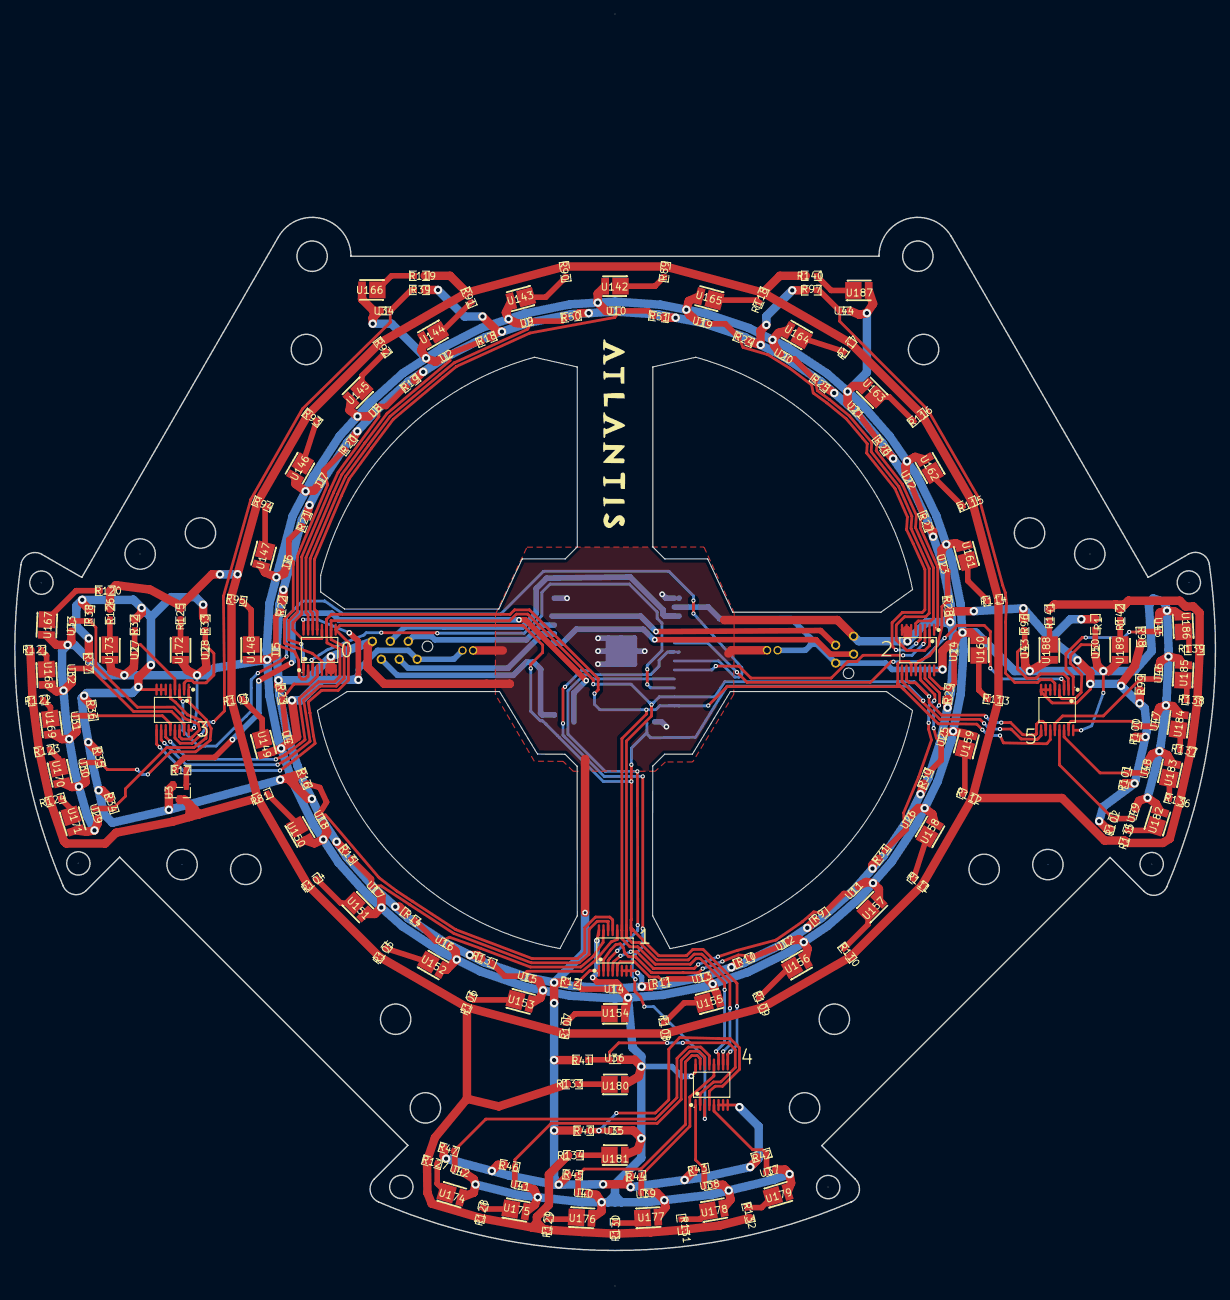
[picture p9: board Bodensensor_2025_final.kicad_pcb from above]

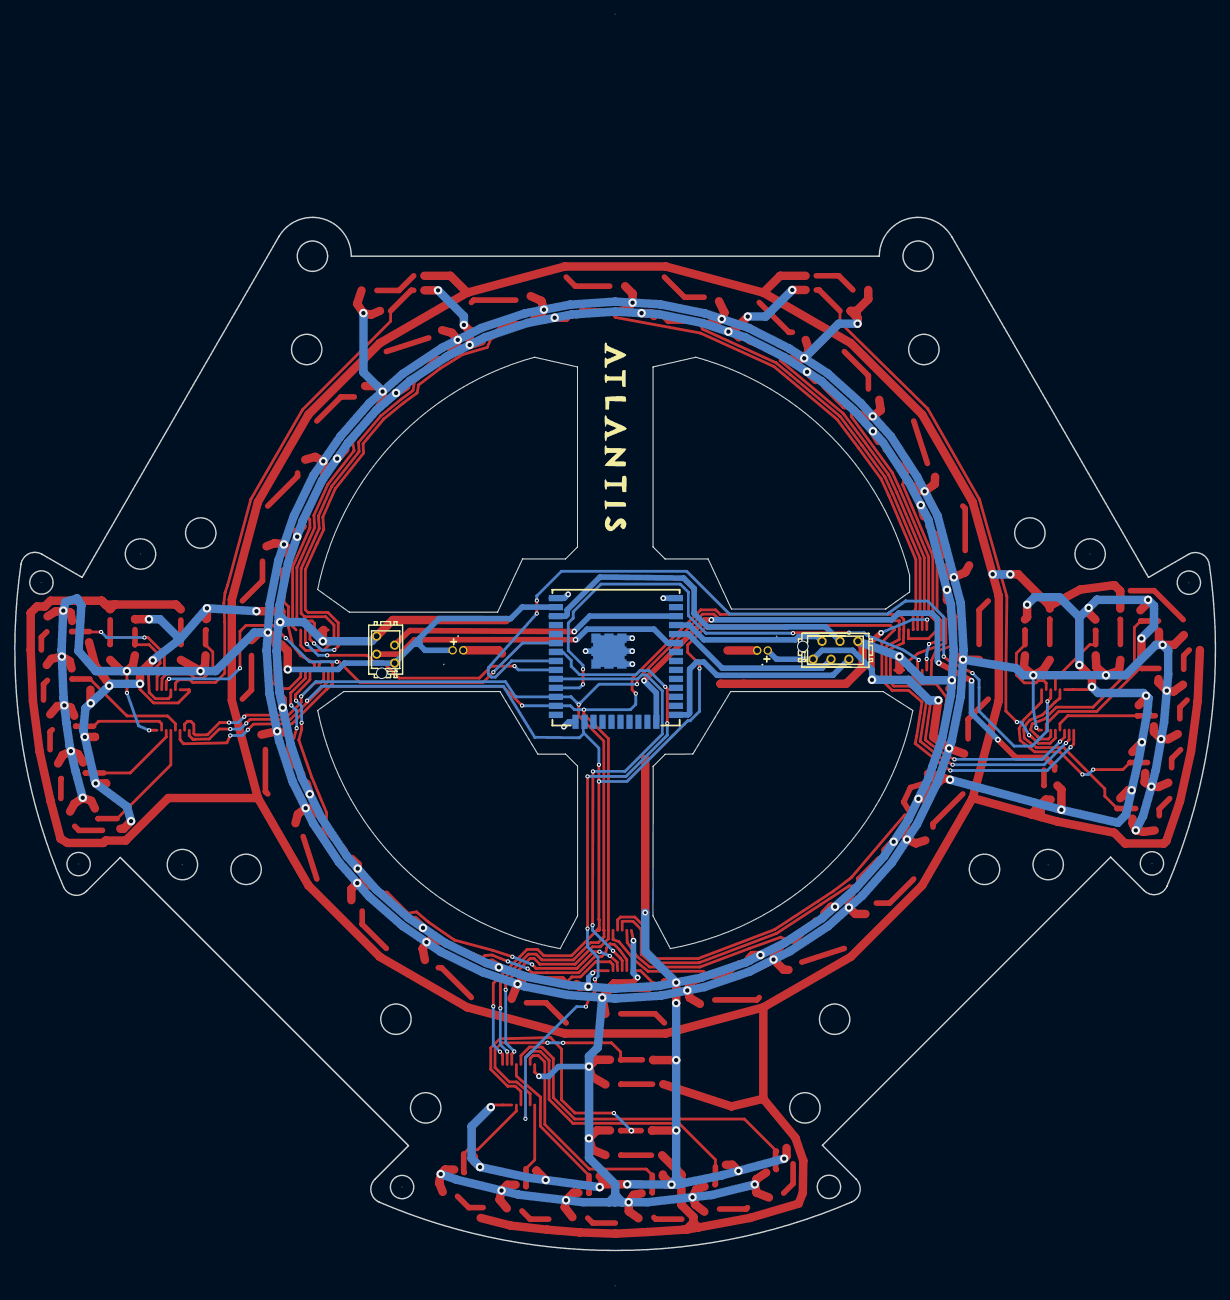
[picture p10: board Bodensensor_2025_final.kicad_pcb from below]

Board: 2 copper layers, 170.0 x 146.2 mm, 205 parts (5 on the bottom side), 116 nets.
