rstiebel/Bohlebots_Atlantis/(commit log)

2026-06-28 Added Vision system
    [CalibrationPoint.yaml]
2026-06-28 Added arduino files
2026-06-28 Add PCB and SCH
    [Bodensensor_2025_final.kicad_pcb, Bodensensor_2025_final.kicad_sch, MainPlatine.kicad_pcb, MainPlatine.kicad_sch, tasterPlatine2025_01.kicad_pcb, tasterPlatine2025_01.kicad_sch, zwischenPlatine2025_01.kicad_pcb, zwischenPlatine2025_01.kicad_sch]
